seanboe/eOPRA_suite/README.md

# eOPRA_suite

Contains the board files (KiCAD + gerbers) and CLI for the eOPRA device control suite used in research on transfemoral and transtibial prosthetics
at the MIT Biomechatronics Lab.
