seanboe/eOPRA_suite/firmware/README.md

# Notes

utilities:
- encoder 
- decoder
- buzzer
