seanboe/eOPRA_suite/eOPRA_interface/altium_impedance_calcs.png

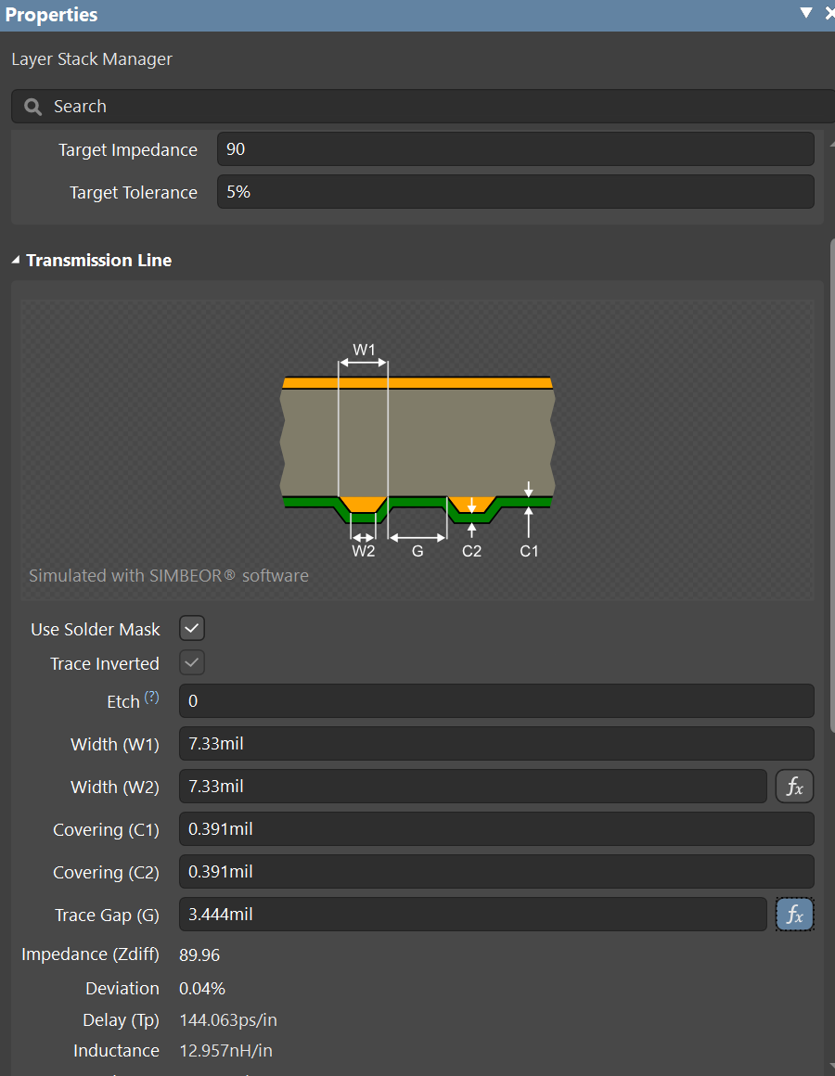
eOPRA_interface/altium_impedance_calcs.png
