seanboe/eOPRA_suite/eOPRA_interface/eOPRA_interface Case v5.stl

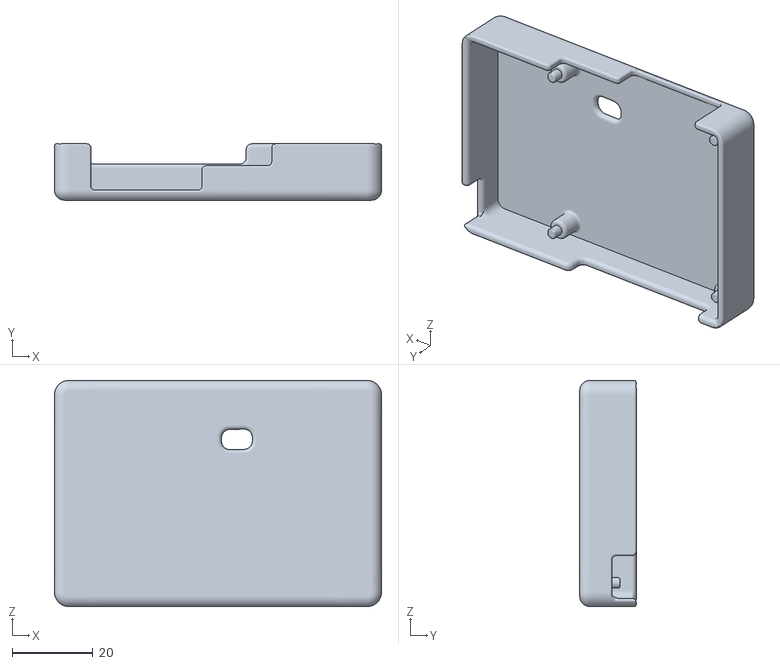
[picture p2: CAD file, 2023-10-02]
eOPRA_interface/eOPRA_interface Case v5.stl
81.0 x 14.0 x 56.0
