seanboe/eOPRA_suite/eOPRA_interface/gerbers/eOPRA_interface-drl_map.dxf

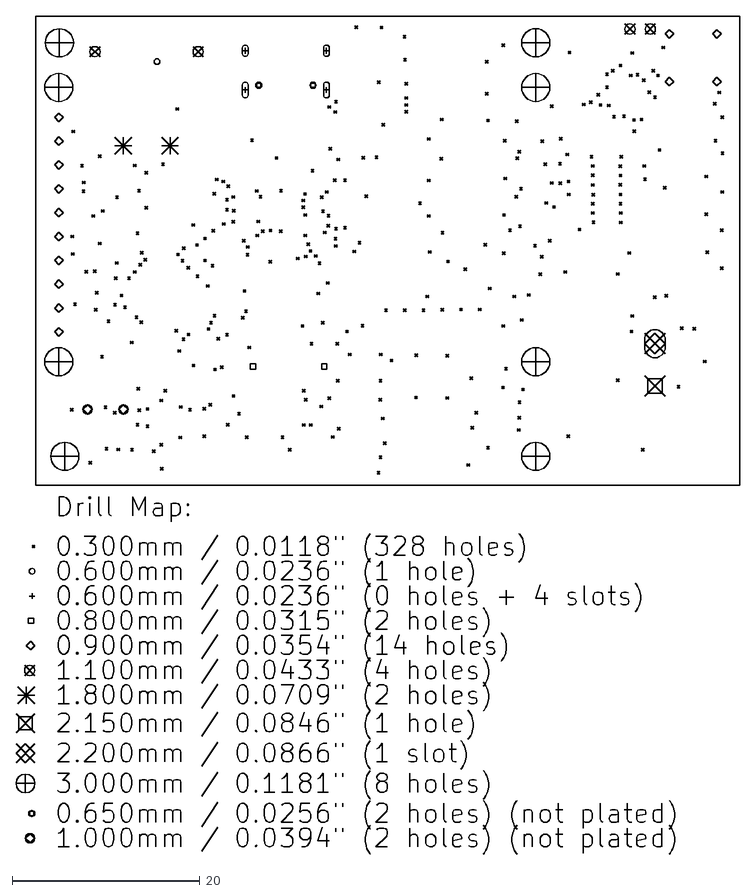
[picture p3: CAD file, 2023-09-21]
eOPRA_interface/gerbers/eOPRA_interface-drl_map.dxf
77.1 x 89.3
