seanboe/eOPRA_suite/eOPRA_interface/project_models/TL3365AF180QG.step

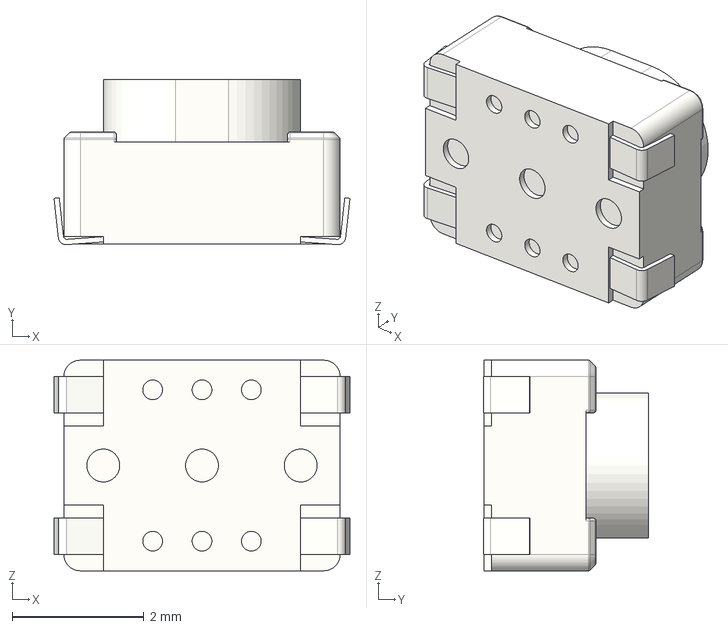
[picture p4: CAD file, 2023-08-30]
eOPRA_interface/project_models/TL3365AF180QG.step
4.50 x 2.51 x 3.20 mm
