seanboe/eOPRA_suite/eOPRA_interface/project_models/WSON-8_6X5_WIN.step

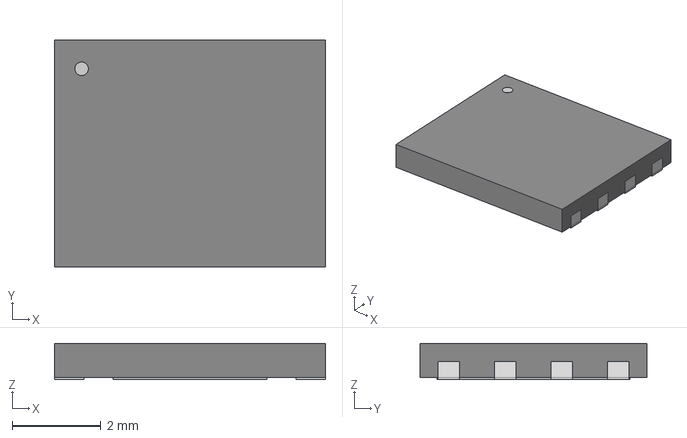
[picture p5: CAD file, 2023-08-30]
eOPRA_interface/project_models/WSON-8_6X5_WIN.step
6.10 x 5.11 x 0.815 mm
