seanboe/eOPRA_suite/eOPRA_interface/project_models/crystal.step

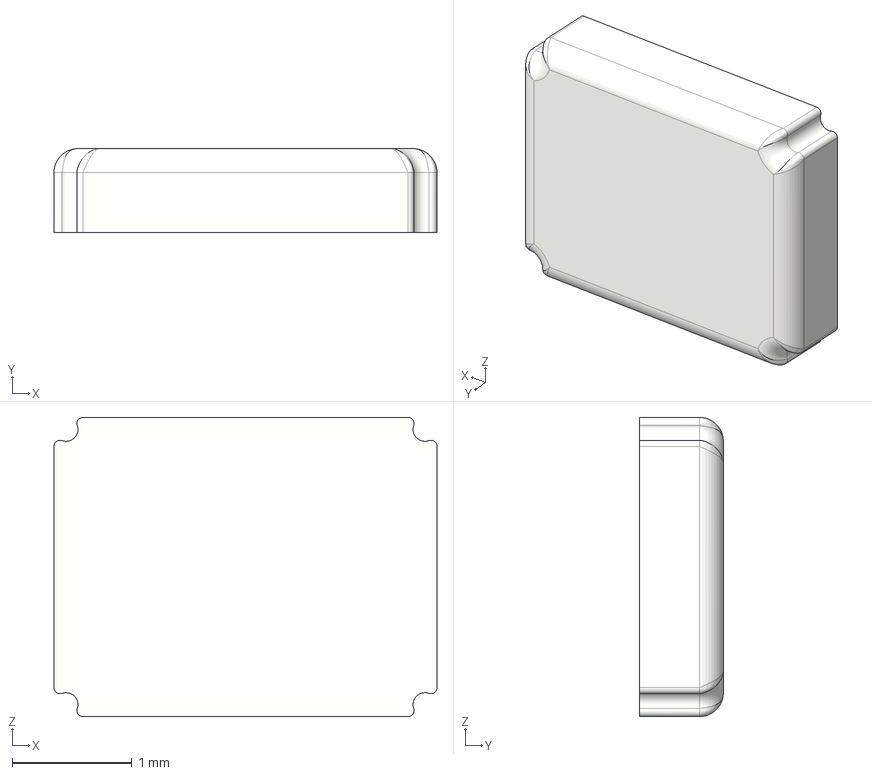
[picture p6: CAD file, 2023-08-30]
eOPRA_interface/project_models/crystal.step
3.20 x 0.7 x 2.50 mm
