seanboe/eOPRA_suite/eOPRA_interface/project_models/SWDIO.step

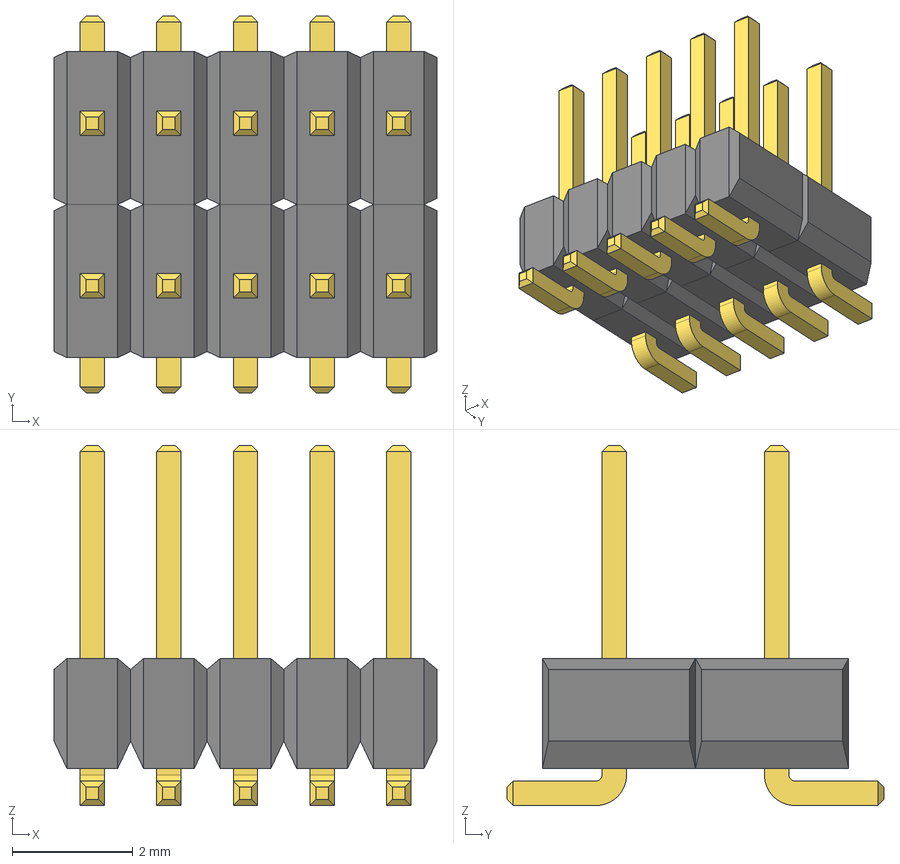
[picture p7: CAD file, 2023-08-30]
eOPRA_interface/project_models/SWDIO.step
6.35 x 6.25 x 5.97 mm
