seanboe/eOPRA_suite/eOPRA_interface/project_models/A11AH.stp

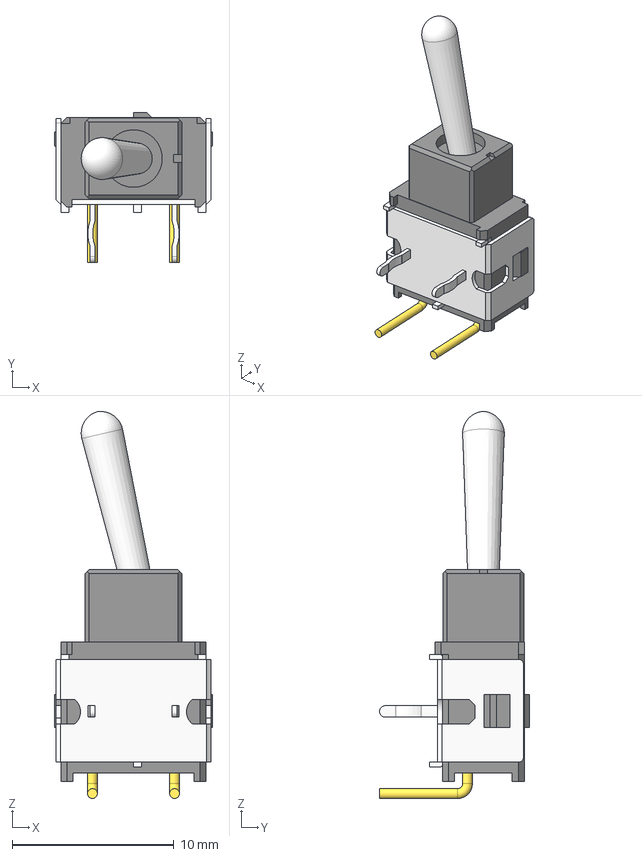
[picture p8: CAD file, 2023-08-30]
eOPRA_interface/project_models/A11AH.stp
9.80 x 9.27 x 23.9 mm
AA-toggle-toggle
A1H-toggle-bracket_ra
A11H-toggle-terminals
A1-toggle-body
