seanboe/eOPRA_suite/eOPRA_interface/project_models/Molex_2035642017.step

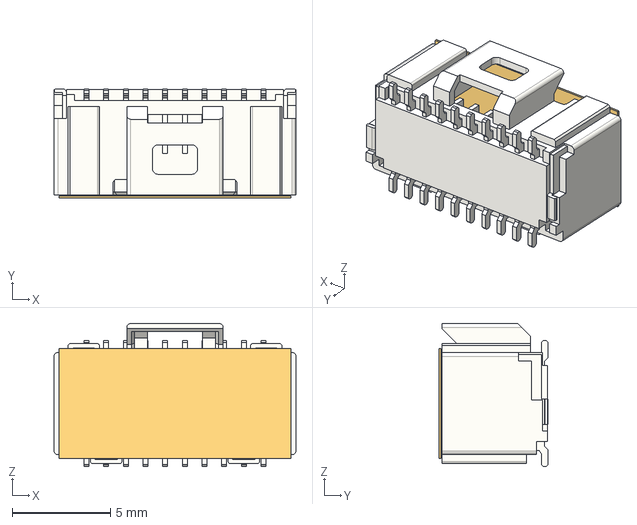
[picture p9: CAD file, 2023-08-30]
eOPRA_interface/project_models/Molex_2035642017.step
12.3 x 5.57 x 7.27 mm
