seanboe/eOPRA_suite/eOPRA_interface/project_models/ESP8266-12E_ESP-12E.step

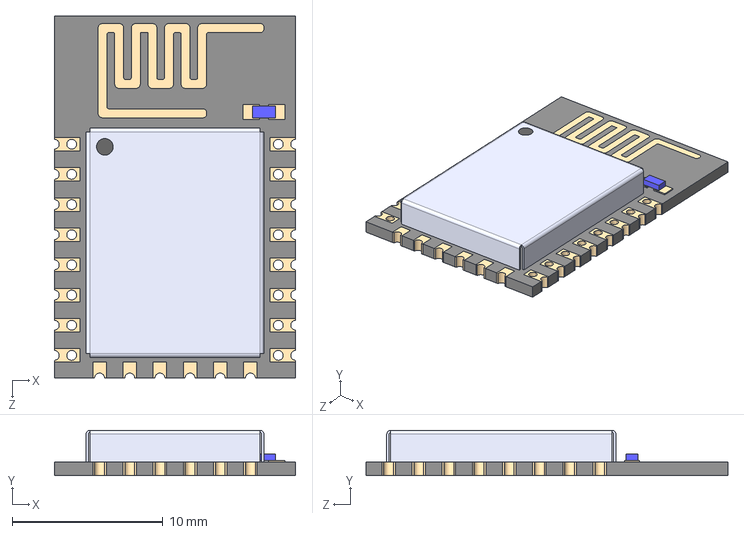
[picture p10: CAD file, 2023-08-17]
eOPRA_interface/project_models/ESP8266-12E_ESP-12E.step
16.0 x 3.00 x 24.0 mm
