seanboe/eOPRA_suite/eOPRA_interface/project_models/buzzer.step

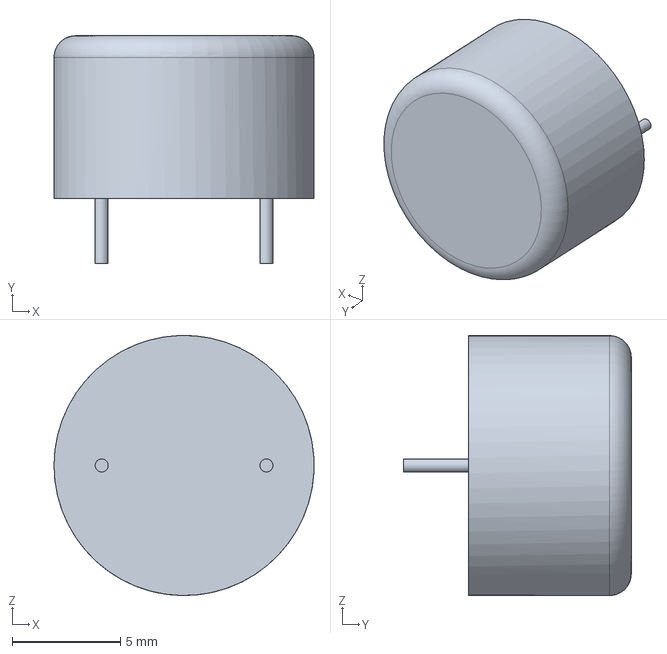
[picture p11: CAD file, 2023-08-14]
eOPRA_interface/project_models/buzzer.step
12.0 x 10.5 x 12.0 mm
