seanboe/eOPRA_suite/eOPRA_interface/project_models/LCD.step

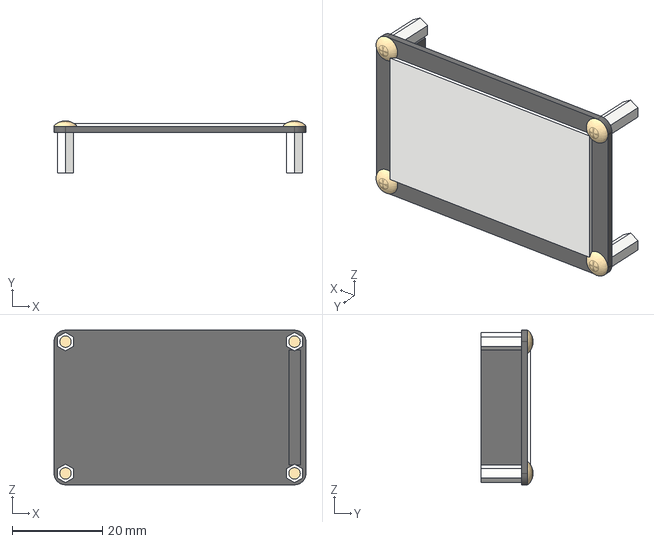
[picture p12: CAD file, 2023-08-14]
eOPRA_interface/project_models/LCD.step
55.9 x 11.5 x 34.3 mm
base x 2
screen
