seanboe/eOPRA_suite/eOPRA_interface/project_models/SM04B-GHS-TB_LF__SN_-.step

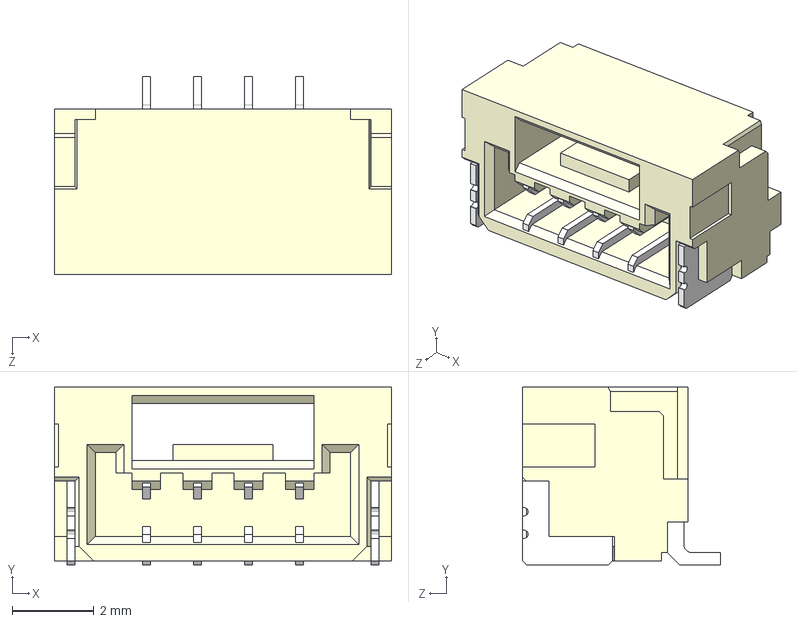
[picture p13: CAD file, 2023-08-01]
eOPRA_interface/project_models/SM04B-GHS-TB_LF__SN_-.step
8.25 x 4.35 x 4.85 mm
