seanboe/eOPRA_suite/eOPRA_interface/project_models/RP2040.step

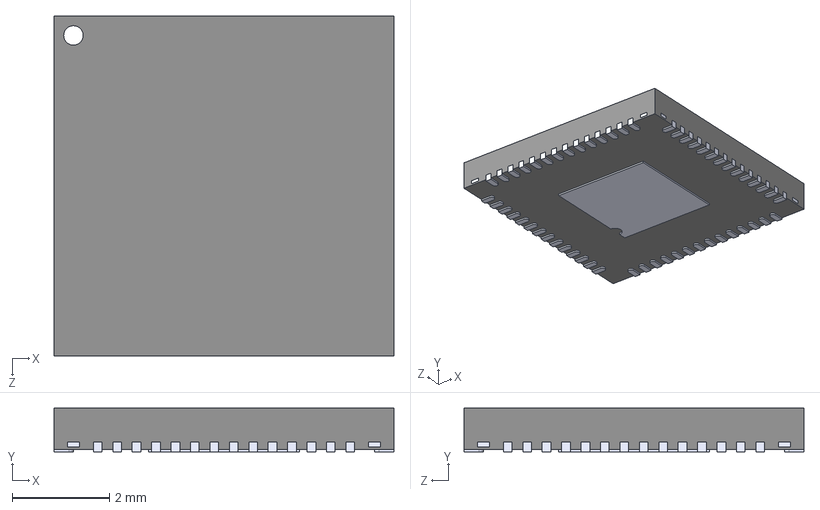
[picture p14: CAD file, 2023-08-01]
eOPRA_interface/project_models/RP2040.step
7.00 x 0.9 x 7.00 mm
