seanboe/eOPRA_suite/eOPRA_interface/project_models/rot_encoder v1.step

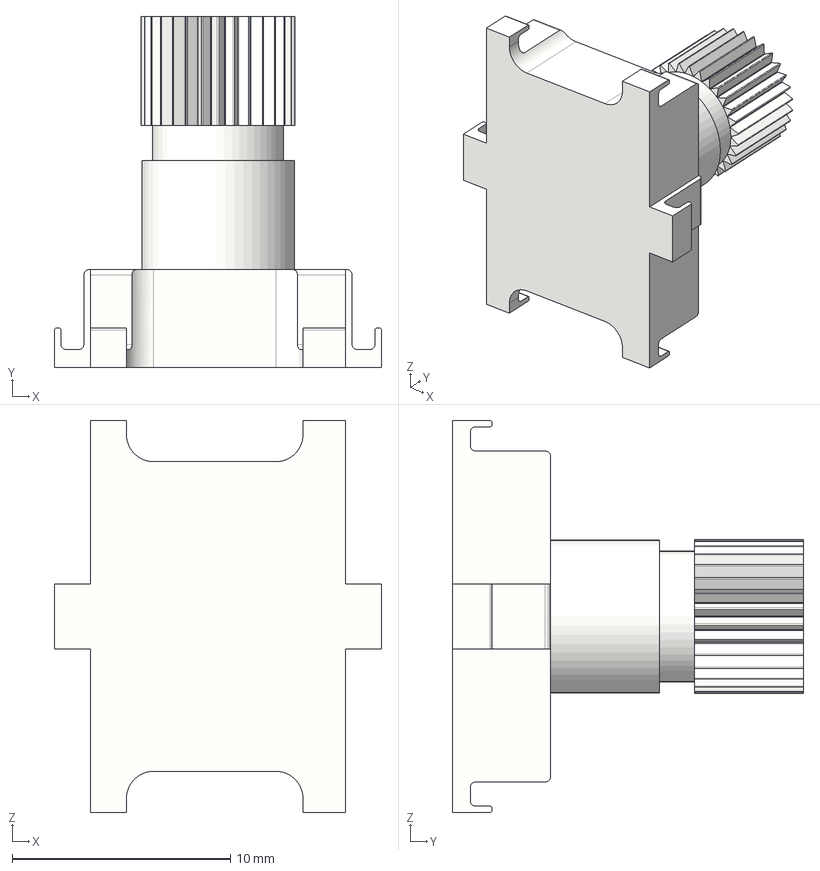
[picture p15: CAD file, 2023-08-01]
eOPRA_interface/project_models/rot_encoder v1.step
15.0 x 16.1 x 18.0 mm
