seanboe/eOPRA_suite/eOPRA_interface/project_models/74HC4051BQ_115.step

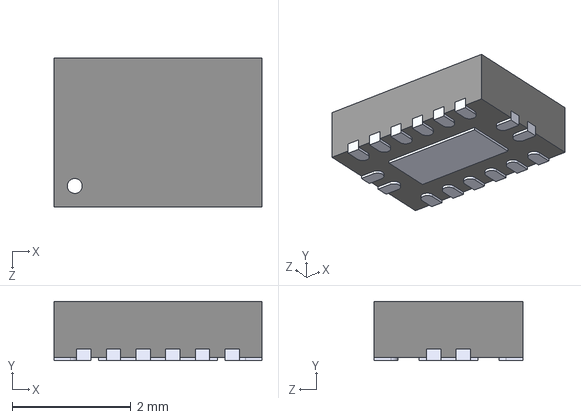
[picture p16: CAD file, 2023-08-01]
eOPRA_interface/project_models/74HC4051BQ_115.step
3.50 x 1.00 x 2.50 mm
