seanboe/eOPRA_suite/eOPRA_interface/project_models/XT30PW-M.step

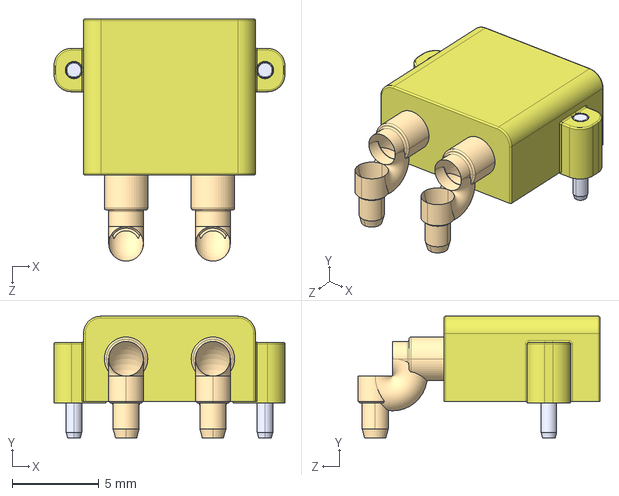
[picture p17: CAD file, 2023-08-01]
eOPRA_interface/project_models/XT30PW-M.step
13.3 x 7.00 x 14.0 mm
