seanboe/eOPRA_suite/eOPRA_interface/project_models/G3VM_401DY v1.step

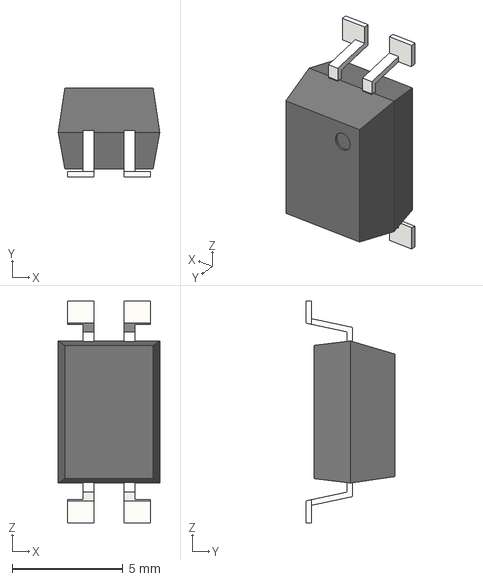
[picture p18: CAD file, 2023-08-01]
eOPRA_interface/project_models/G3VM_401DY v1.step
4.58 x 4.00 x 10.0 mm
