seanboe/eOPRA_suite/eOPRA_interface/project_models/SM02B-GHS-TB_LF__SN_ v2.step

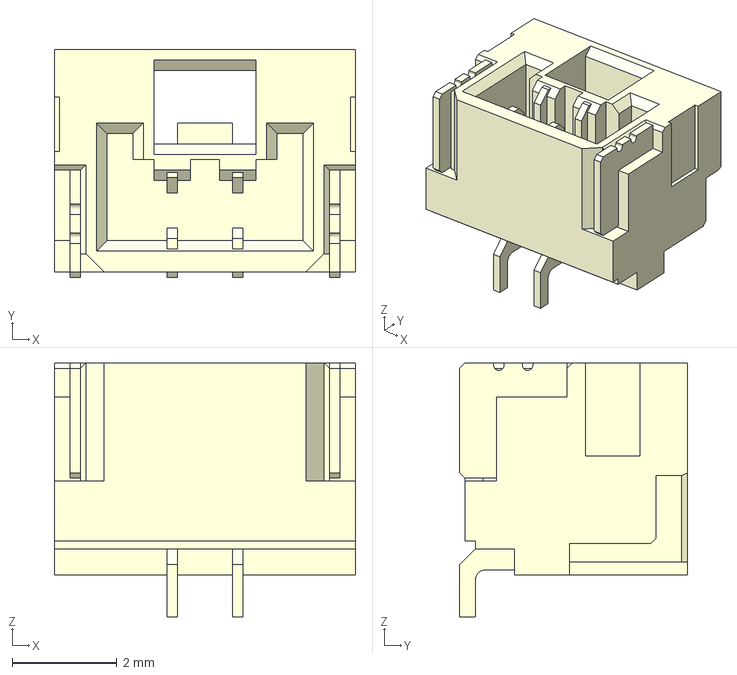
[picture p19: CAD file, 2023-08-01]
eOPRA_interface/project_models/SM02B-GHS-TB_LF__SN_ v2.step
5.75 x 4.35 x 4.85 mm
