seanboe/eOPRA_suite/(list of files, cad)

Other CAD files:
eOPRA_interface/project_models/MCP25625-E_ML.step
eOPRA_interface/project_models/MCP25625.step
