seanboe/eOPRA_suite/eOPRA_interface/eOPRA_interface.kicad_pcb

## KiCad design eOPRA_interface/eOPRA_interface.kicad_pcb (2023-10-02)

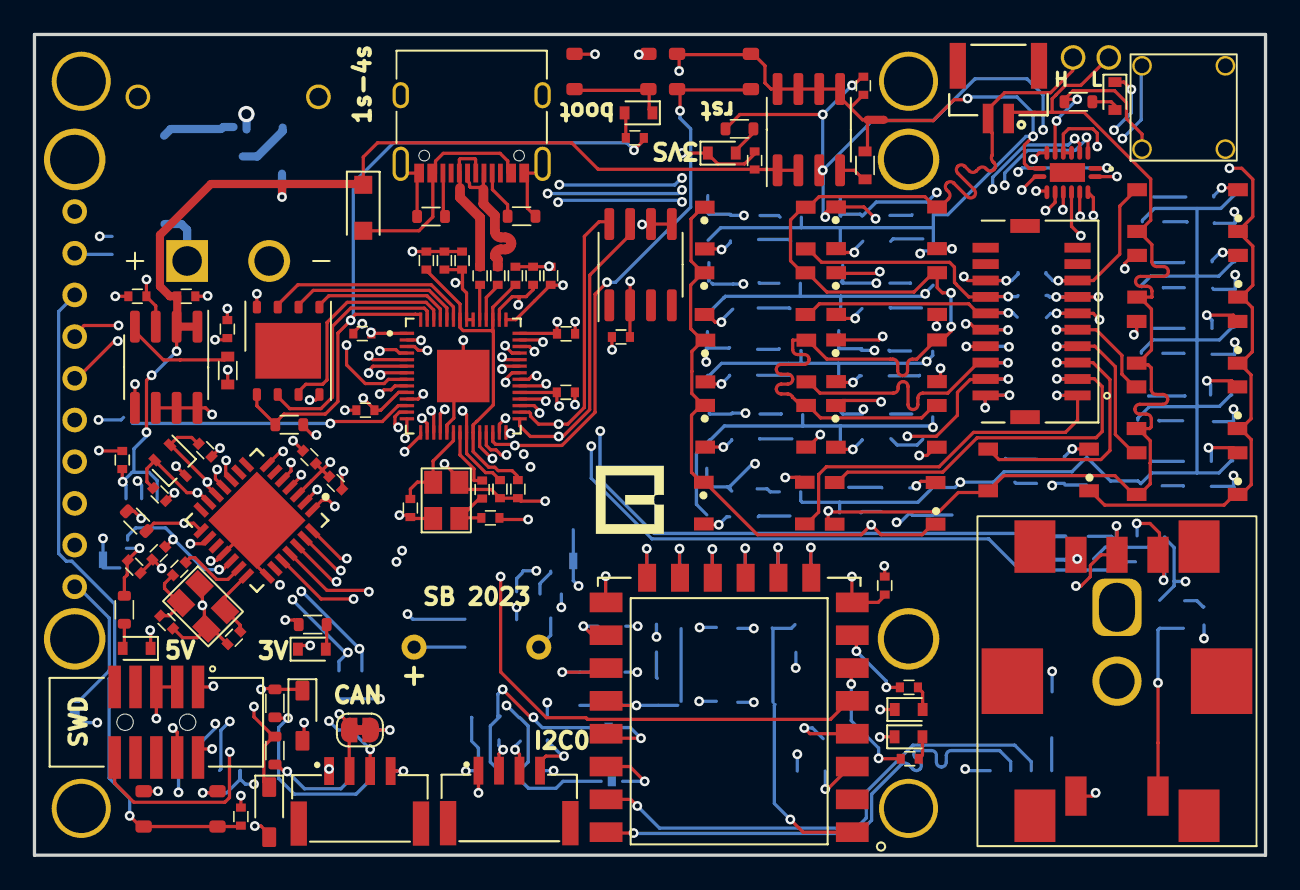
[picture p25: board eOPRA_interface.kicad_pcb from above]

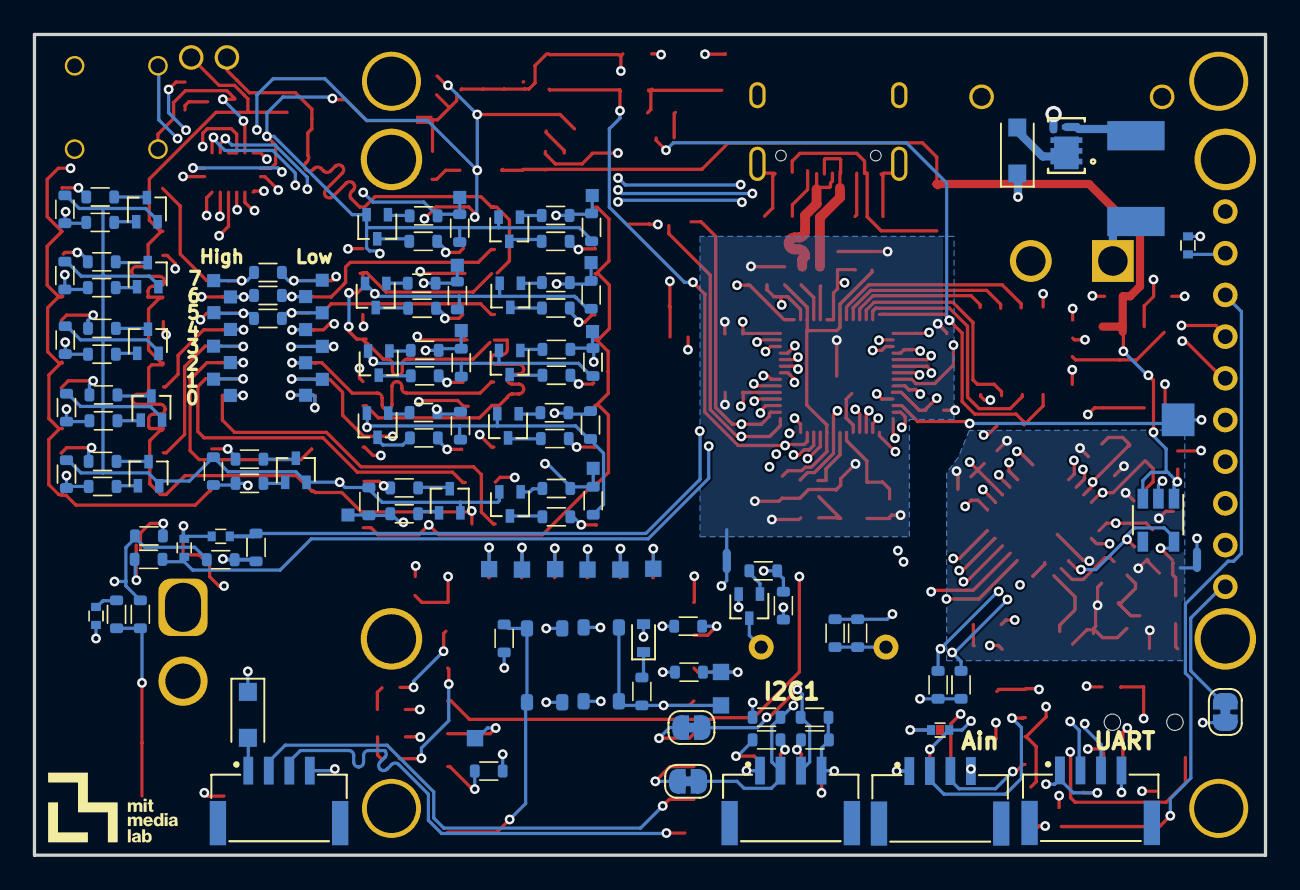
[picture p26: board eOPRA_interface.kicad_pcb from below]

Board: 4 copper layers, 75.0 x 50.0 mm, 254 parts (147 on the bottom side), 185 nets.

Parts:
C1, C3, C6, C16, C17, C19, C20, C28, C30, C31, C32, C33, C34, C36: 1uF; C_1005_402_A
C2, C29: 100pF; C_1608_603_B
C4, C5, C21, C22: 22pF; C_1005_402_A
C7, C8, C9, C10, C11, C12, C13, C14, C15, C18, C25, C26, C27, C35: 0.1uF; C_1005_402_A
C23, C24: 47pF; C_1005_402_A
D1: PESD1CAN; SOT-323_SC-70
D2, D4, D5: D_Schottky; D_SOD-123F
D3, D6, D7, D10, D11, D12, D13, D14: LED; D_0603
D8, D9: D_Zener; SOD-323
F1: Fuse; PTC
J1, J2, J3, J5, J7, J8: CONN_01X04_MALE; JST_SM04B-GHS-TB(LF)(SN)-
J4: CONN_01X02_MALE; JST_SM02B_GHS_TB
J6: CONN_02X10; MOLEX_2035642017
JP1, JP2, JP3, JP4: SolderJumper-2_P1.3mm_Bridged_RoundedPad1.0x1.5mm
NT1, NT2, NT3: net-tie; NetTie-2_SMD_Pad0.5mm
Q1, Q7, Q9, Q11, Q14, Q15, Q17, Q18, Q20, Q22, Q23, Q26, Q27, Q30, Q31, Q34: G3VM-351VY1-TR05
Q2, Q3, Q4, Q6, Q8, Q10, Q12, Q13, Q16, Q19, Q21, Q24, Q25, Q28, Q29, Q32, Q33: RU1J002YNTCL; SOT-323FL
Q5: Q_PMOS_GSD; SON_8DU-T1-GE3_VIS
R1, R2: 5k1; R_1608_603_B
R3, R6, R11, R13, R14, R15, R16, R19, R20, R22, R25, R27, R28, R30, R33, R36, R39, R40, R45, R50, R52, R57, R58, R63, R64, R69, R70, R75, R76, R77, R78, R79, R82, R83: 10k; R_1608_603_B
R4, R17, R18: 1k; R_1005_402_A
R5, R7, R8, R26, R29, R31, R32, R34, R35, R37, R38, R41, R42, R43, R44, R46, R47, R48, R49, R51, R53, R54, R55, R56, R59, R60, R61, R62, R65, R66, R67, R68, R71, R72, R73, R74, R89, R90, R91: 300; R_1608_603_B
R9, R10, R12, R21: 4k7; R_1608_603_B
R23, R24: 27.4; R_1005_402_A
R80, R84, R86: 120; R_1005_402_A
R81: 500; R_1005_402_A
R85, R87, R88: N/A; R_1608_603_B
SP1: buzzer; BUZZER
SW1, SW2, SW3, SW5, SW6: SW_Push; TL3365AF180QG
SW4: AS11AH
SW7: Rotary_Encoder_Switch; PEC11S-929K-S0015
TP1, TP3, TP5, TP6, TP7, TP8, TP9, TP11, TP12: TEST; test_point_1.0mm_square
TP2: test_point_2mm_square
TP4, TP10: TEST; plated_hole_1.1x1.5mm
TP13, TP14, TP15, TP16, TP17, TP18, TP19, TP20, TP21, TP22, TP23, TP24, TP25, TP26, TP27, TP28, TP29, TP30, TP31, TP32, TP33, TP34, TP35, TP36: test_point_0.8mm_square
U1: USB_C_2.0; USB_C_XKB_U262-16XN-4BVC11
U2: ARM-SWD-10
U3, U15: AP2213-8_SOIC; SOIC-8_3.9x4.9mm_P1.27mm
U4: DS3231MZ+; SOIC-8_3.9x4.9mm_P1.27mm
U5: XT-X; AMASS_XT30PW-M
U6, U7, U8, U9: Mounting-holes; plated_hole_3.0x3.6mm
U10: RP2040; QFN40P700X700X90-57N
U11: W25Q128JVP; GD25Q16CWIGR
U12: TFT_BOB
U13: MCP25625; QFN6x6_P65
U14: AP2205-50; TSOT-23-5
U16: ESP8266-12E_ESP-12E
U17: QFN50P250X350X100-17N
Y1: 16Mhz 12pF; 4-smd
Y3: 12Mhz 12pF; 4-smd

Connections:
+1V1: C14.1, C15.1, C16.1, U10.23 (DVDD), U10.45 (VREG_VOUT), U10.50 (DVDD)
+3V3: C3.1, C7.1, C8.1, C9.1, C10.1, C11.1, C12.1, C13.1, C17.1, C18.2, C25.1, C31.2, C32.2, C33.1, C34.1, C35.2, D2.1 (K), D6.2 (A), J1.4, J2.4, J3.1, J5.4, J8.4, JP1.2, R8.1, R9.2, R10.2, R11.2, R12.2, R16.2, R18.1, R20.1, R21.2, R22.1, R25.1, R51.2, R77.1, R78.2, R79.2, R83.1, R90.2, U2.1 (Vref), U3.3 (VOUT), U4.2 (VCC), U10.1 (IOVDD), U10.10 (IOVDD), U10.22 (IOVDD), U10.33 (IOVDD), U10.42 (IOVDD), U10.43 (ADC_AVDD), U10.44 (VREG_VIN), U10.48 (USB_VDD), U10.49 (IOVDD), U11.8 (VCC), U12.9 (VCC), U13.3 (VDD), U13.11 (VIO), U16.8 (VCC)
+5V: C19.2, C20.1, R91.2, U13.19 (VDDA), U14.5 (VOUT)
+BATT: D5.2 (A), Q5.2 (S)
/A_IN_2: J3.2, R27.1
/A_IN_3: J3.3, R28.1
/BUZZER: R6.2, R7.2, U10.11 (GPIO8)
/CAN_H: C24.2, D1.2 (A2), J5.3, R80.2, U13.13 (CANH)
/CAN_L: C23.2, D1.1 (A1), J5.2, JP4.1, U13.12 (CANL)
/ENC_BUTTON: C36.2, R13.2
/ESP-Wifi/EN: R83.2, U16.3 (EN)
/ESP-Wifi/ESP_INT: U10.9 (GPIO7), U16.5 (IO14)
/ESP-Wifi/GPIO0: R14.2, SW1.1, SW1.3, TP9.1, U16.18 (IO0)
/ESP-Wifi/GPIO2: R20.2, TP1.1, U16.17 (IO2)
/ESP-Wifi/LED1: R86.2, U16.6 (IO12)
/ESP-Wifi/LED2: R84.2, U16.7 (IO13)
/ESP-Wifi/~RESET: R22.2, SW5.1, SW5.3, U16.1 (RESET)
/MISO0: U10.6 (GPIO4), U12.2 (MISO)
/MOSI0: U10.5 (GPIO3), U12.4 (MOSI)
/ROT_ENC_0: C26.1, R75.2, U10.36 (GPIO24)
/ROT_ENC_1: C27.1, R76.1, U10.37 (GPIO25)
/RX: J1.2, U10.3 (GPIO1)
/RXD: J7.2, U16.21 (RXD)
/SCK0: U10.4 (GPIO2), U12.3 (SCK)
/SCL0: J8.2, R10.1, U10.32 (GPIO21)
/SCL1: J2.2, JP2.1, R21.1, U4.8 (SCL), U10.30 (GPIO19)
/SDA0: J8.3, R9.1, U10.31 (GPIO20)
/SDA1: J2.3, JP3.1, R12.1, U4.7 (SDA), U10.29 (GPIO18)
/SD_CS: U10.8 (GPIO6), U12.6 (SD_CS)
/SWCLK: U2.4 (SWDCLK/TCK), U10.24 (SWCLK)
/SWDIO: U2.2 (SWDIO/TMS), U10.25 (SWD)
/TFT_CS: TP2.1, U10.12 (GPIO9), U12.5 (TFT_CS)
/TFT_DC: U10.7 (GPIO5), U12.7 (D/C)
/TX: J1.3, U10.2 (GPIO0)
/TXD: J7.3, U16.22 (TXD)
/USB_D+: R23.1, U1.A6 (D+), U1.B6 (D+)
/USB_D-: R24.1, U1.A7 (D-), U1.B7 (D-)
/peripherals/switch: R13.1, R79.1, SW7.S1
/peripherals/~TFT_RESET: R18.2, SW3.1, SW3.3, U12.8 (~RESET)
/processor/A_IN_2_PIN: D8.1 (K), R27.2, U10.38 (GPIO26_ADC0)
/processor/A_IN_3_PIN: D9.1 (K), R28.2, U10.39 (GPIO27_ADC1)
/processor/CAN_CS: R11.1, U10.40 (GPIO28_ADC2), U13.1 (~CS)
/processor/CAN_INT: U10.34 (GPIO22), U13.25 (~INT)
/processor/CAN_RESET: R25.2, U10.41 (GPIO29_ADC3), U13.2 (~RESET)
/processor/CAN_STBY: R15.1, U10.27 (GPIO16), U13.15 (STBY)
/processor/ENC_CTL_0: U10.16 (GPIO13), U17.1 (A0)
/processor/ENC_CTL_1: U10.17 (GPIO14), U17.2 (A1)
/processor/ENC_CTL_2: U10.18 (GPIO15), U17.3 (A2)
/processor/MISO1: U10.15 (GPIO12), U13.28 (MISO)
/processor/MOSI1: U10.14 (GPIO11), U13.27 (MOSI)
/processor/QSPI_CS: R16.1, R17.1, U10.56 (QSPI_SS), U11.1 (~CS)
/processor/QSPI_SCLK: U10.52 (QSPI_SCLK), U11.6 (CLK)
/processor/QSPI_SD0: U10.53 (QSPI_SD0), U11.5 (DI(IO0))
/processor/QSPI_SD1: U10.55 (QSPI_SD1), U11.2 (DO(IO1))
/processor/QSPI_SD2: U10.54 (QSPI_SD2), U11.3 (WP(IO2))
/processor/QSPI_SD3: U10.51 (QSPI_SD3), U11.7 (HOLD(IO3))
/processor/SCK1: U10.13 (GPIO10), U13.26 (SCK)
/processor/~Rx0BF: U10.35 (GPIO23), U13.24 (~Rx0BF)
/processor/~Tx0RTS: U10.28 (GPIO17), U13.7 (~Tx0RTS)
/regulator/SYS_PWR: C1.2, C6.2, C28.2, D4.1 (K), D5.1 (K), U3.1 (EN), U3.2 (VIN), U14.1 (VIN), U14.3 (EN), U15.1 (EN), U15.2 (VIN)
/switch_control/CHAN_0: R3.2, R26.2, R30.2, R31.2, TP29.1, U17.15 (Y0)
/switch_control/CHAN_1: R19.2, R39.2, R41.2, R46.2, TP30.1, U17.14 (Y1)
/switch_control/CHAN_2: R33.2, R34.2, R36.2, R37.2, TP31.1, U17.13 (Y2)
/switch_control/CHAN_3: R40.2, R42.2, R45.2, R47.2, TP32.1, U17.12 (Y3)
/switch_control/CHAN_4: R50.2, R53.2, R57.2, R59.2, TP33.1, U17.11 (Y4)
/switch_control/CHAN_5: R63.2, R65.2, R69.2, R71.2, TP34.1, U17.10 (Y5)
/switch_control/CHAN_6: R52.2, R54.2, R58.2, R60.2, TP35.1, U17.9 (Y6)
/switch_control/CHAN_7: R64.2, R66.2, R70.2, R72.2, TP36.1, U17.7 (Y7)
/~RESET: SW6.1, SW6.3, U2.10 (~RESET), U10.26 (~RUN)
CHAN_0A_OUT: J6.1, Q1.3, TP13.1
CHAN_0B_OUT: J6.2, Q7.3, TP14.1
CHAN_1A_OUT: J6.3, Q14.3, TP15.1
CHAN_1B_OUT: J6.4, Q17.3, TP16.1
CHAN_2A_OUT: J6.5, Q9.3, TP20.1
CHAN_2B_OUT: J6.6, Q11.3, TP19.1
CHAN_3A_OUT: J6.7, Q15.3, TP18.1
CHAN_3B_OUT: J6.8, Q18.3, TP17.1
CHAN_4A_OUT: J6.9, Q20.3, TP21.1
CHAN_4B_OUT: J6.10, Q22.3, TP22.1
CHAN_5A_OUT: J6.11, Q26.3, R88.2, TP23.1
CHAN_5B_OUT: J6.12, Q30.3, R88.1, TP24.1
CHAN_6A_OUT: J6.13, Q23.3, R85.2, TP28.1
CHAN_6B_OUT: J6.14, Q27.3, R85.1, TP27.1
CHAN_7A_OUT: J6.15, Q31.3, R87.2, TP26.1
CHAN_7B_OUT: J6.16, Q34.3, R87.1, TP25.1
EMG_HIGH: J4.1, Q1.4, Q9.4, Q14.4, Q15.4, Q20.4, Q23.4, Q26.4, Q31.4, TP4.1
EMG_LOW: J4.2, Q7.4, Q11.4, Q17.4, Q18.4, Q22.4, Q27.4, Q30.4, Q34.4, TP10.1
GND: C1.1, C2.2, C3.2, C6.1, C18.1, C26.2, C27.2, C28.1, C29.2, C30.2, C31.1, C32.1, C34.2, C36.1, D7.1 (K), D8.2 (A), D9.2 (A), D11.1 (K), D12.1 (K), D13.1 (K), J1.1, J2.1, J3.4, J5.1, J7.4, J8.1, NT1.2, NT2.2, NT3.2, Q3.2 (S), Q5.1 (G), R1.1, R2.2, R6.1, R82.2, SW1.2, SW1.4, SW2.2, SW2.4, SW3.2, SW3.4, SW5.2, SW5.4, SW6.2, SW6.4, SW7.C, SW7.S2, U1.A1 (GND), U1.A12 (GND), U1.B1 (GND), U1.B12 (GND), U1.S1 (SHIELD), U2.3 (GND), U2.5 (GND), U3.5 (GND), U3.6 (GND), U3.7 (GND), U3.8 (GND), U4.5 (GND), U4.6 (VBAT), U5.1 (-), U11.4 (GND), U12.10 (GND), U14.2 (GND), U15.5 (GND), U15.6 (GND), U15.7 (GND), U15.8 (GND), U16.15 (GND)
GNDISO1: C4.1, C5.2, C7.2, C8.2, C9.2, C10.2, C11.2, C12.2, C13.2, C14.2, C15.2, C16.2, C17.2, C25.2, NT1.1, U10.19 (TESTEN), U10.57 (GND), Y3.2, Y3.4
GNDISO2: C19.1, C20.2, C21.2, C22.1, C23.1, C24.1, C33.2, C35.1, D1.3 (common), D14.1 (K), NT3.1, R15.2, U13.18 (VSS), U13.22 (GND), U13.29 (EP), Y1.2, Y1.4
GNDREF: D10.1 (K), NT2.1, Q2.2 (S), Q4.2 (S), Q6.2 (S), Q8.2 (S), Q10.2 (S), Q12.2 (S), Q13.2 (S), Q16.2 (S), Q19.2 (S), Q21.2 (S), Q24.2 (S), Q25.2 (S), Q28.2 (S), Q29.2 (S), Q32.2 (S), Q33.2 (S), R3.1, R19.1, R30.1, R33.1, R36.1, R39.1, R40.1, R45.1, R50.1, R52.1, R57.1, R58.1, R63.1, R64.1, R69.1, R70.1, U17.4 (~G2A), U17.5 (~G2B), U17.8 (GND)
unnamed: C5.1, R4.1, Y3.1
unnamed: C21.1, R81.1, Y1.1
unnamed: D2.2 (A), J7.1
unnamed: D3.2 (A), R17.2
unnamed: D3.1 (K), SW2.1, SW2.3
unnamed: D6.1 (K), R14.1
unnamed: D7.2 (A), R89.1
unnamed: D10.2 (A), R29.1
unnamed: D11.2 (A), R84.1
unnamed: D12.2 (A), R86.1
unnamed: D13.2 (A), R90.1
unnamed: D14.2 (A), R91.1
unnamed: JP4.2, R80.1
unnamed: Q1.2, R5.2
unnamed: Q2.3 (D), R5.1
unnamed: Q2.1 (G), R26.1
unnamed: Q3.3 (D), SP1.2 (-)
unnamed: Q3.1 (G), R7.1
unnamed: Q4.3 (D), R48.1
unnamed: Q4.1 (G), R46.1
unnamed: F1.2, Q5.3 (D)
unnamed: Q6.3 (D), R32.1
unnamed: Q6.1 (G), R31.1
unnamed: Q7.2, R32.2
unnamed: Q8.3 (D), R35.1
unnamed: Q8.1 (G), R34.1
unnamed: Q9.2, R35.2
unnamed: Q10.3 (D), R38.1
unnamed: Q10.1 (G), R37.1
unnamed: Q11.2, R38.2
unnamed: Q12.3 (D), R43.1
unnamed: Q12.1 (G), R41.1
unnamed: Q13.3 (D), R44.1
unnamed: Q13.1 (G), R42.1
unnamed: Q14.2, R43.2
unnamed: Q15.2, R44.2
unnamed: Q16.3 (D), R49.1
unnamed: Q16.1 (G), R47.1
unnamed: Q17.2, R48.2
unnamed: Q18.2, R49.2
unnamed: Q19.3 (D), R55.1
unnamed: Q19.1 (G), R53.1
unnamed: Q20.2, R55.2
unnamed: Q21.3 (D), R56.1
unnamed: Q21.1 (G), R54.1
unnamed: Q22.2, R61.2
unnamed: Q23.2, R56.2
unnamed: Q24.3 (D), R61.1
unnamed: Q24.1 (G), R59.1
unnamed: Q25.3 (D), R62.1
unnamed: Q25.1 (G), R60.1
unnamed: Q26.2, R67.2
unnamed: Q27.2, R62.2
unnamed: Q28.3 (D), R67.1
unnamed: Q28.1 (G), R65.1
unnamed: Q29.3 (D), R68.1
unnamed: Q29.1 (G), R66.1
unnamed: Q30.2, R73.2
unnamed: Q31.2, R68.2
unnamed: Q32.3 (D), R73.1
unnamed: Q32.1 (G), R71.1
unnamed: Q33.3 (D), R74.1
unnamed: Q33.1 (G), R72.1
unnamed: Q34.2, R74.2
unnamed: R75.1, R78.1, SW7.A
unnamed: R76.2, R77.2, SW7.B
unnamed: R8.2, R51.1, SP1.1 (+)
unnamed: R29.2, SW4.1 (A), U17.6 (G1)
unnamed: R2.1, U1.A5 (CC1)
unnamed: R1.2, U1.B5 (CC2)
unnamed: C2.1, U3.4 (BYP)
unnamed: F1.1, U5.2 (+)
unnamed: R23.2, U10.47 (USB_D+)
unnamed: R24.2, U10.46 (USB_D-)
unnamed: C4.2, U10.20 (XIN), Y3.3
unnamed: R4.2, U10.21 (XOUT)
unnamed: JP1.1, U12.1 (LITE)
unnamed: C22.2, U13.21 (OSC1), Y1.3
unnamed: R81.2, U13.20 (OSC2)
unnamed: U13.5 (RxCAN), U13.10 (RXD)
unnamed: U13.4 (TxCAN), U13.16 (TXD)
unnamed: C29.1, U15.4 (BYP)
unnamed: TP6.1, U16.9 (CS0)
unnamed: JP3.2, U16.19 (IO4)
unnamed: JP2.2, U16.20 (IO5)
unnamed: TP11.1, U16.11 (IO9)
unnamed: TP12.1, U16.12 (IO10)
unnamed: R82.1, U16.16 (IO15)
unnamed: TP3.1, U16.4 (IO16)
unnamed: TP8.1, U16.10 (MISO)
unnamed: TP7.1, U16.13 (MOSI)
unnamed: TP5.1, U16.14 (SCLK)
SWITCHING_3V3: C30.1, Q1.1, Q7.1, Q9.1, Q11.1, Q14.1, Q15.1, Q17.1, Q18.1, Q20.1, Q22.1, Q23.1, Q26.1, Q27.1, Q30.1, Q31.1, Q34.1, R89.2, SW4.2 (B), U15.3 (VOUT), U17.16 (VDD)
VUSB: D4.2 (A), U1.A4 (VBUS), U1.A9 (VBUS), U1.B4 (VBUS), U1.B9 (VBUS)
