seanboe/eOPRA_suite/(commit log)

2023-08-01 schematic v1.0 finished
    [74HC4051BQ_115.step, G3VM_401DY v1.step, MCP25625-E_ML.step, RP2040.step, SM02B-GHS-TB_LF__SN_ v2.step, SM04B-GHS-TB_LF__SN_-.step, XT30PW-M.step, eOPRA_interface.kicad_pcb]
2023-08-01 Version updates
    [eOPRA_interface.kicad_sch, peripherals.kicad_sch, processor.kicad_sch, regulator.kicad_sch, switch_control.kicad_sch]
2023-08-04 starting layout
    [eOPRA_interface.kicad_pcb, eOPRA_interface.kicad_sch, peripherals.kicad_sch, processor.kicad_sch, switch_control.kicad_sch]
2023-08-14 before esp
    [LCD.step, buzzer.step, eOPRA_interface.kicad_pcb, eOPRA_interface.kicad_sch, processor.kicad_sch, regulator.kicad_sch, switch_control.kicad_sch]
2023-08-15 before 4 layer
    [eOPRA_interface.kicad_pcb, eOPRA_interface.kicad_sch, peripherals.kicad_sch, processor.kicad_sch]
2023-08-16 preliminary finish
    [eOPRA_interface.kicad_pcb, eOPRA_interface.kicad_sch, peripherals.kicad_sch, processor.kicad_sch, regulator.kicad_sch, switch_control.kicad_sch]
2023-08-17 draft 2 wifi finish
    [ESP-Wifi.kicad_sch, ESP8266-12E_ESP-12E.step, eOPRA_interface.kicad_pcb, eOPRA_interface.kicad_sch, processor.kicad_sch, regulator.kicad_sch, switch_control.kicad_sch]
2023-10-02 BOARD V1 FINAL
    [eOPRA_interface Case v5.stl, eOPRA_interface.kicad_pcb]
2023-10-02 fixed mounting holes
    [eOPRA_interface.kicad_pcb]
2023-10-06 initial state
    [ESP-Wifi.kicad_sch, eOPRA_interface.kicad_sch, peripherals.kicad_sch, processor.kicad_sch, regulator.kicad_sch, switch_control.kicad_sch]
2023-10-11 Serial byte read problem solved
    [utilities.py]
2023-10-18 i2c working
    seems to be an issue in Wire.cpp - the pin defaults to the values in `pins_arduino.h` and setSDA / setSCL results in a crash - not sure why.
    [main.cpp]
