seanboe/eOPRA_suite/(notices)

Notices in the files:
eOPRA_interface/project_models/A11AH.stp:
author */ ('License CC BY-ND 4.0'),
